f4goh/pwr-swr-meter/README.md

# PWR-SWR-METER

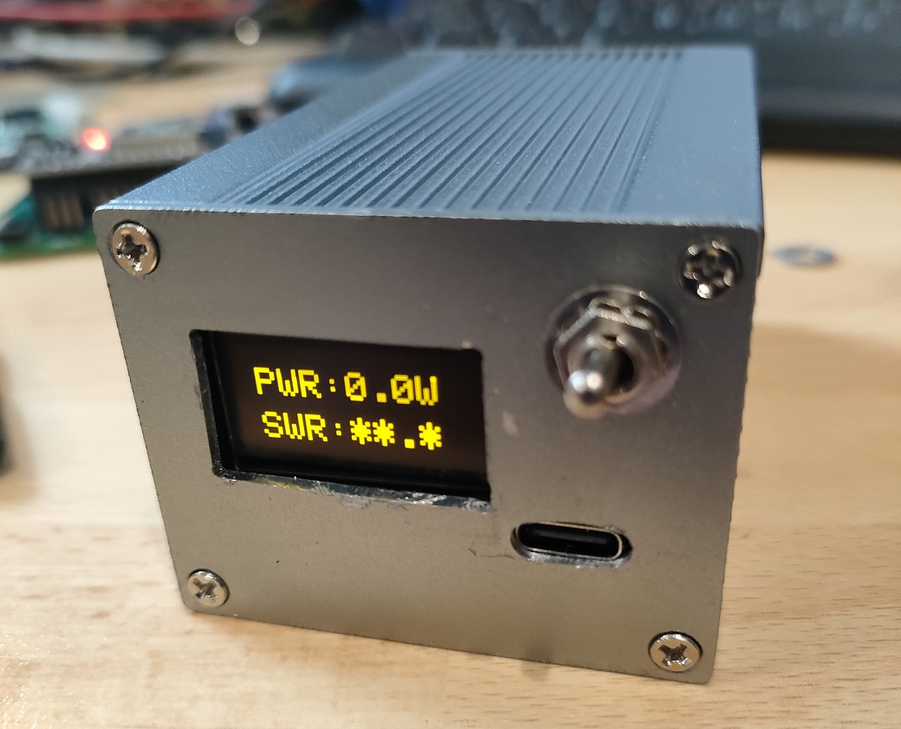
[picture p1: images/swr3.jpg]
swr3 Main board1


## Features :

- 12 Watts max ;
- ATMEGA328p microcontroller with 8 Mhz internal clock ;
- tandem match coupler with BN-43-202 ;
- SSD1306 Oled display ;
- F5BEG's bargraph software ;
- Serial connector for updating with FTDI232 module ;
- BMS (battery management system) ;
- Battery 902535 800mA 3.7V ;
- the programmer used for ATMEGA328p is a [XGECU - pro](https://www.aliexpress.com/premium/XGecu.html) ;
- Initial project from [G8GYW](https://github.com/G8GYW/g8gyw.github.io) for CONSTRUCTING THE TRANSFORMER BN-43-202 .

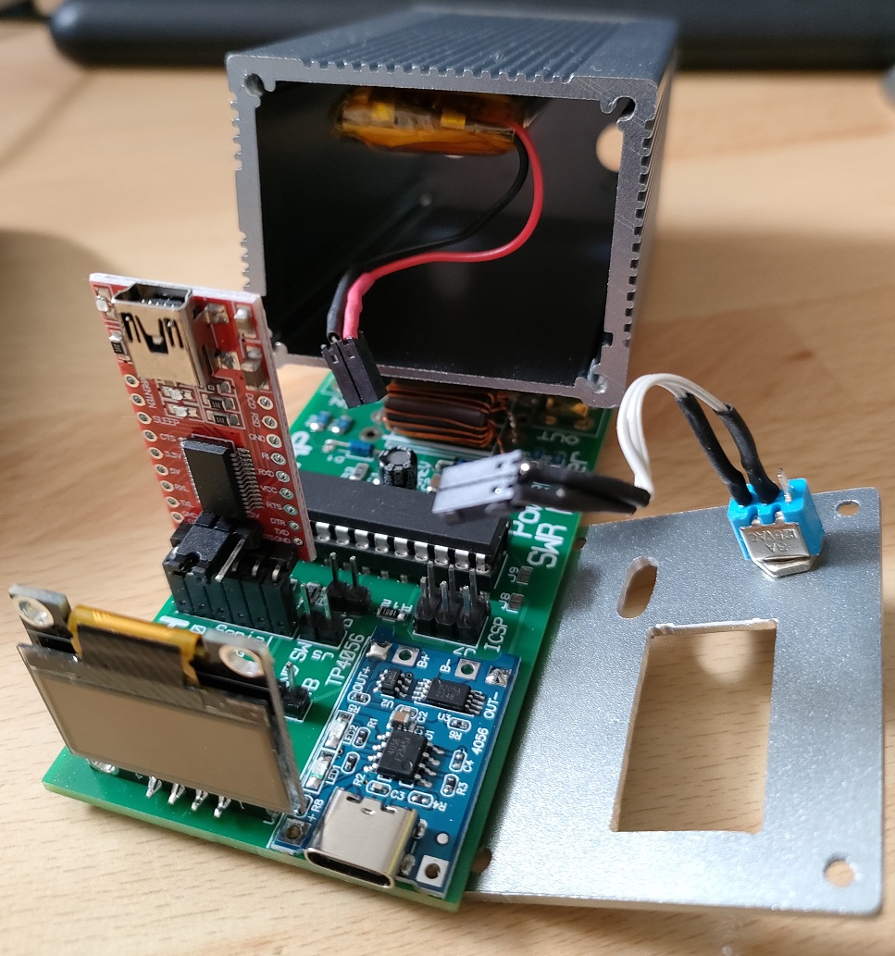
[picture p2: images/total.jpg]
total Main board


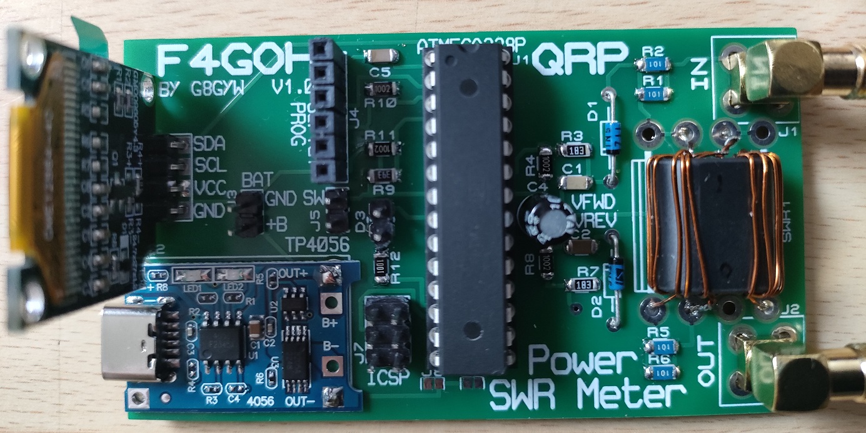
[picture p3: images/swr2.jpg]
swr2 Main board2


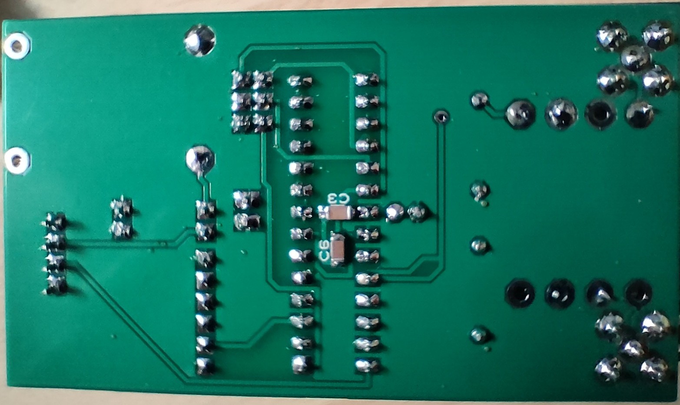
[picture p4: images/swr_back.jpg]
swrback Main board3


## Display :

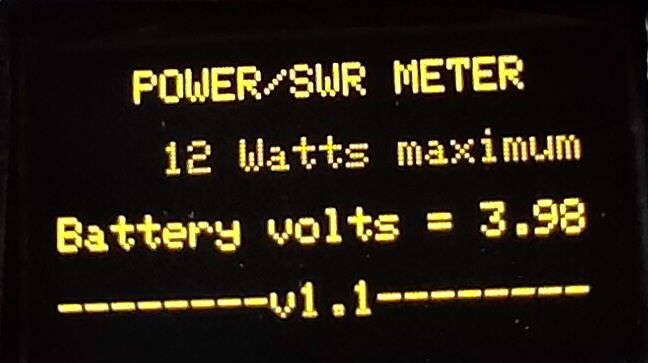
[picture p5: images/intro.jpg]


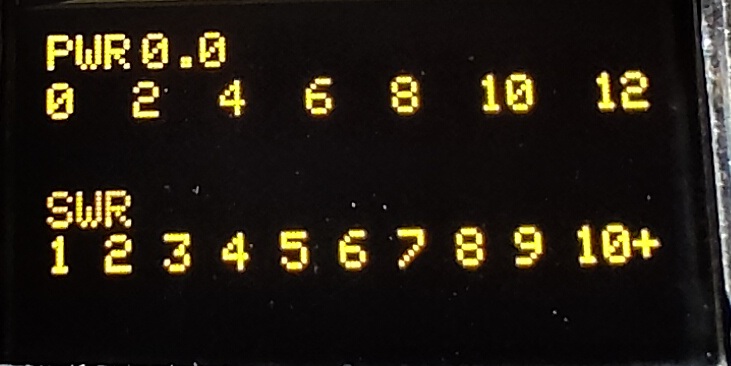
[picture p6: images/init.jpg]


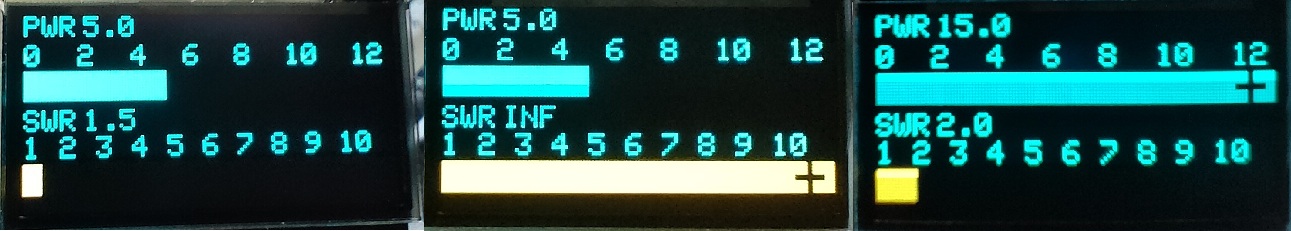
[picture p7: images/pwr_swr.jpg]


## PCB available :

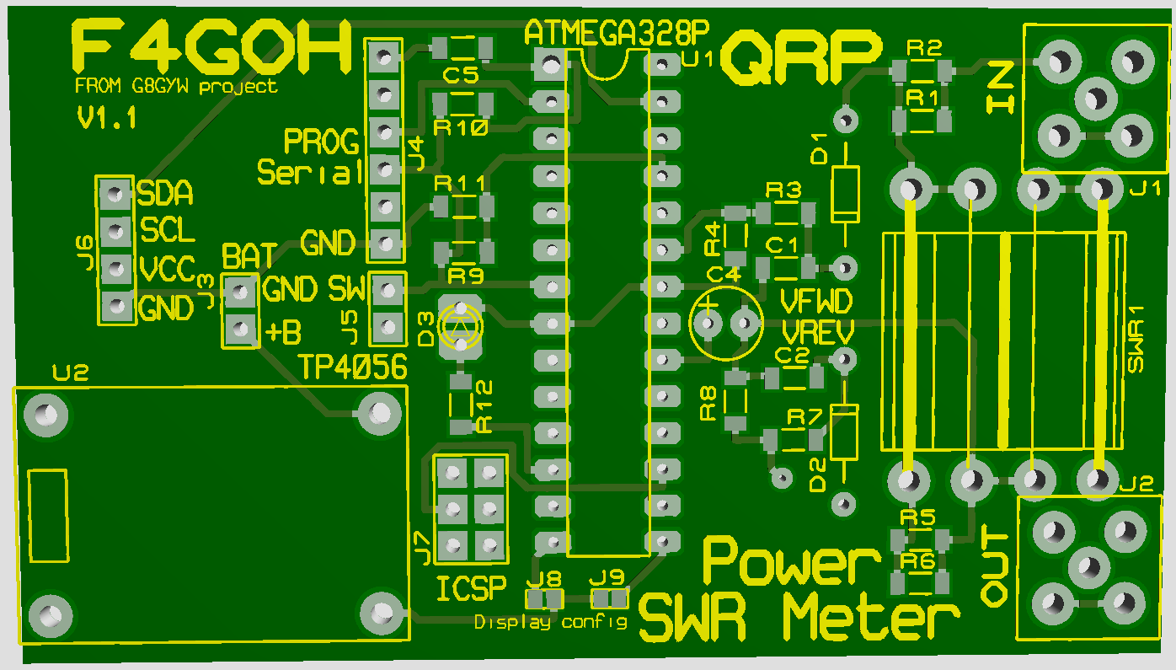
[picture p8: images/swrQRP_PCB.png]
PCB pcb


## F5BCB PWR-SWR-METER :

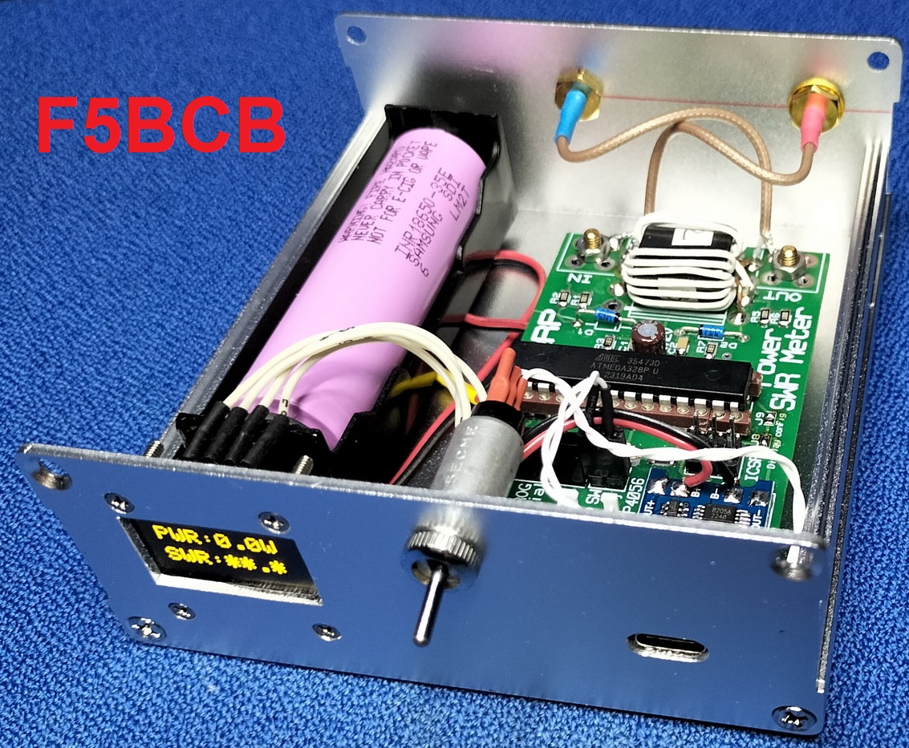
[picture p9: images/F5BCB_1.jpg]
PCB1 pcb1


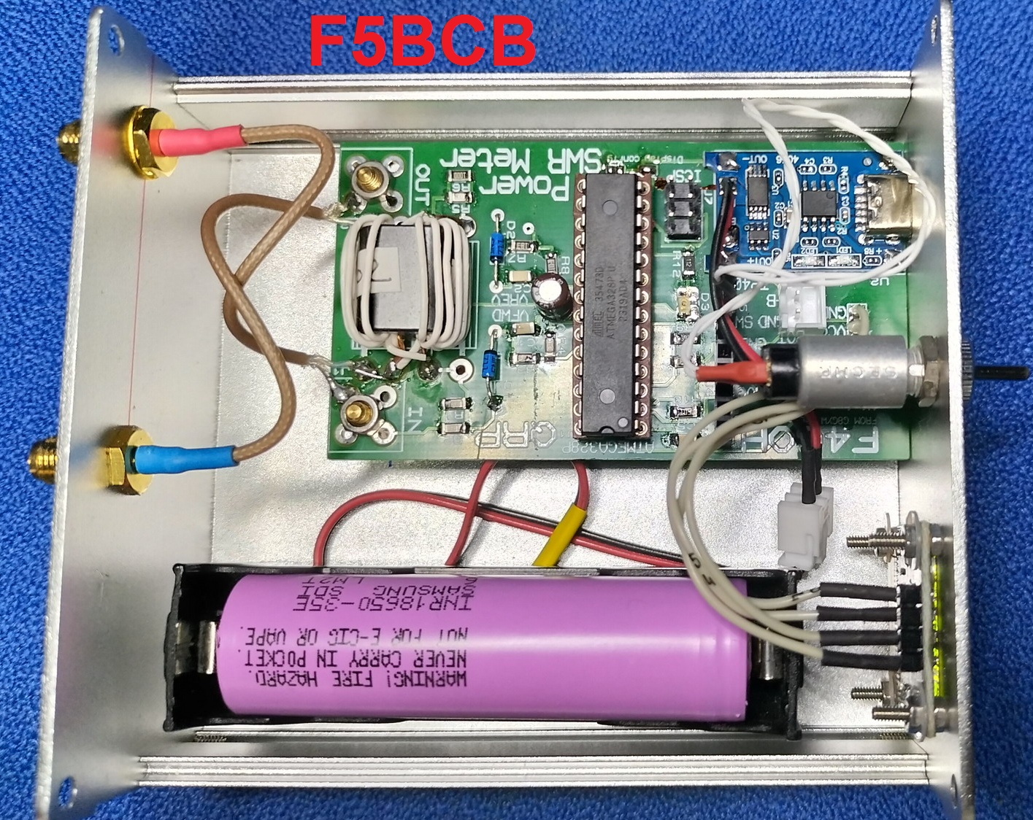
[picture p10: images/F5BCB_2.jpg]
PCB2 pcb2
