f4goh/pwr-swr-meter/programming/README.md

# Software programming with ISP and an Arduino UNO

Use [AVRDUDESS](https://github.com/ZakKemble/AVRDUDESS) with an Arduino UNO to program directly the bootloader and main software (firmware.hex)

## Program an Arduino UNO with AduinoISP software

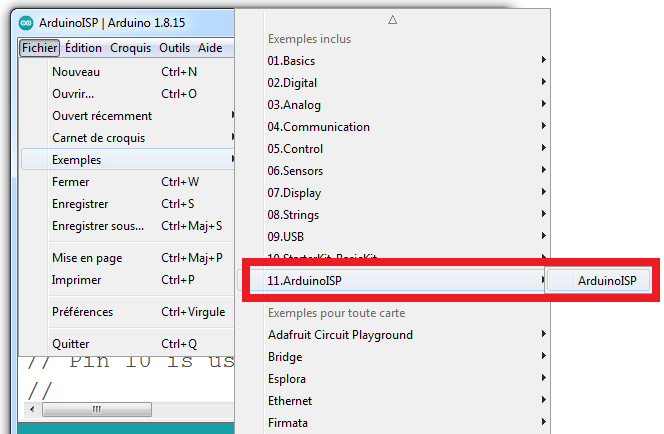
[picture p11: programming/images/Arduino_ISP.png]
isp1


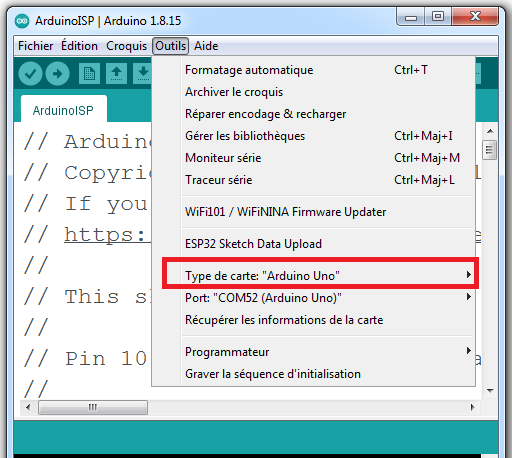
[picture p12: programming/images/Arduino_UNO.png]
isp2


## Connect the Arduino UNO with the SWR power meter
## No battery is connected during this procedure !

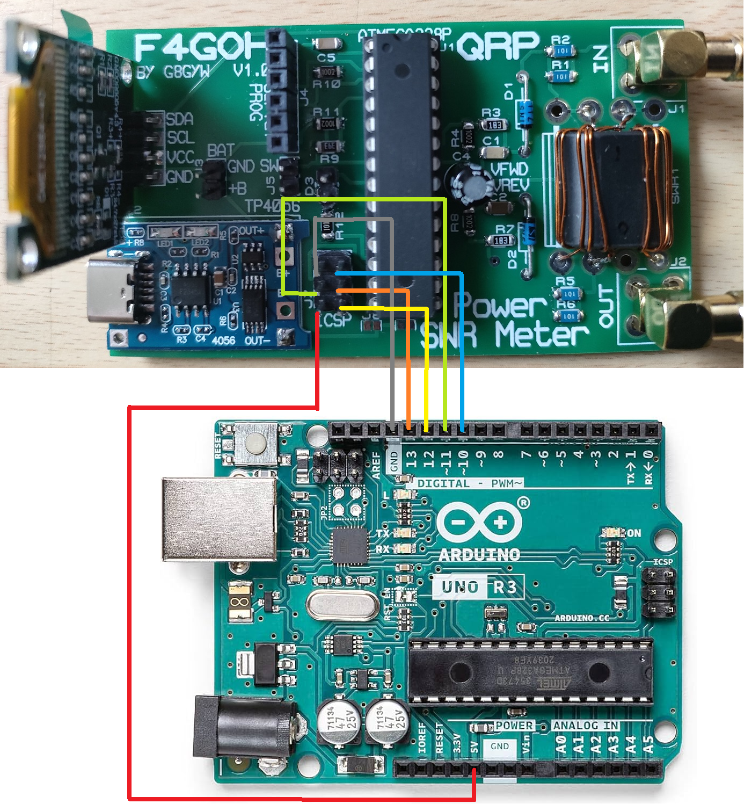
[picture p13: programming/images/Arduino_ISP_wiring.png]
isp3


## Use Avrdudess and program 1,2 and 3

- Arduino board as programmer using arduino ISP firmware
- Select COM port
- Baud rate as 19200
- Select firmware.hex file
- choose write option with format intel HEX
- Select Erase flash and EEPROM
- Program!

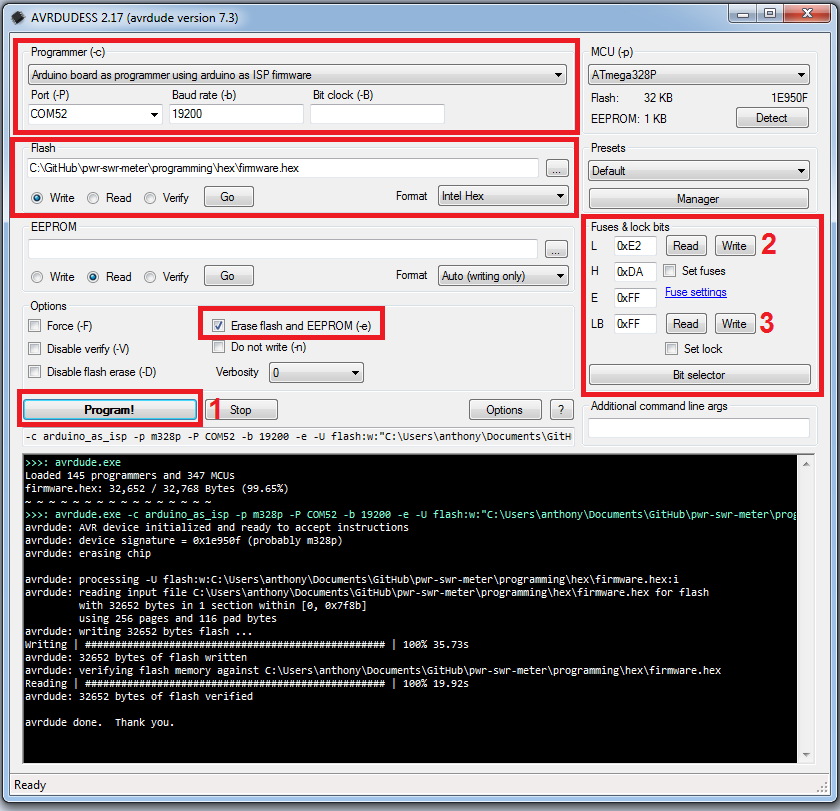
[picture p14: programming/images/avrdudess_en.png]
isp4


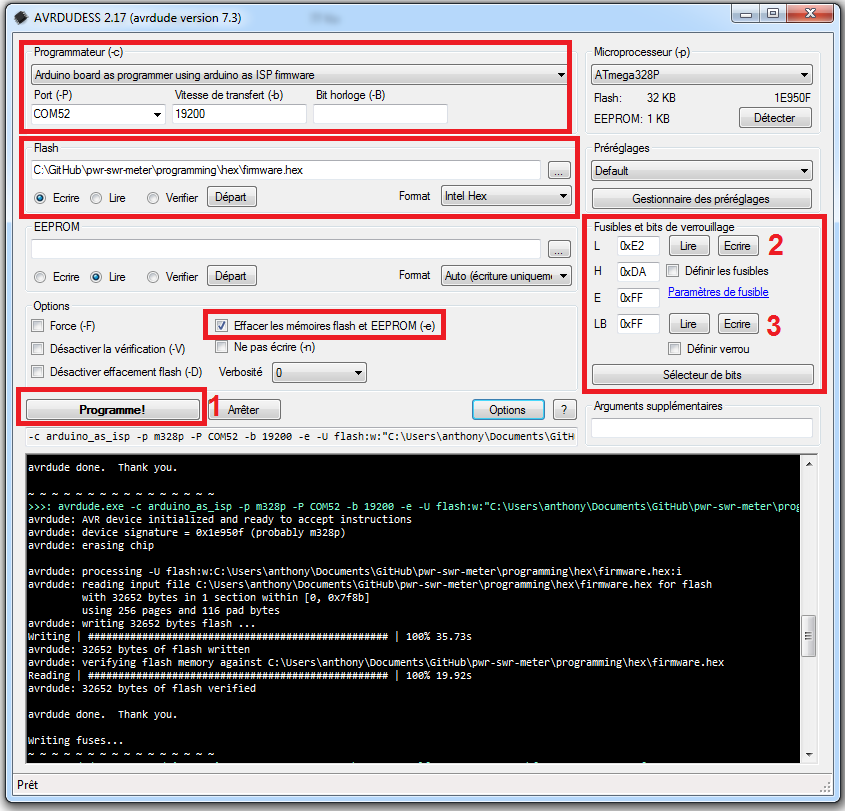
[picture p15: programming/images/avrdudess_fr.png]
isp5


- now check fuse config
- Write fuse config (it select internal 8Mhz clock in atMega328P with bootloader)

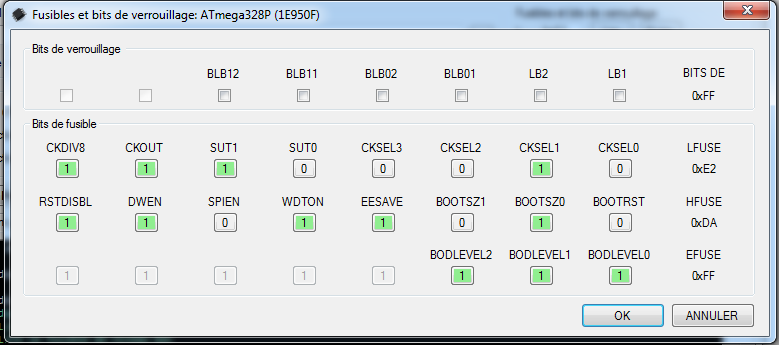
[picture p16: programming/images/fuse.png]
isp6


## Software updating :

if you want to update your own software :

- copy hardware folder into your own Documents/Arduino like C:\Users\anthony\Documents\Arduino
- No need to add MegunoLINK library, Filter.h is included
- Modify QRP_POWER_METER.ino main code
- Select breadBoard-avr in tools menu
- and upload

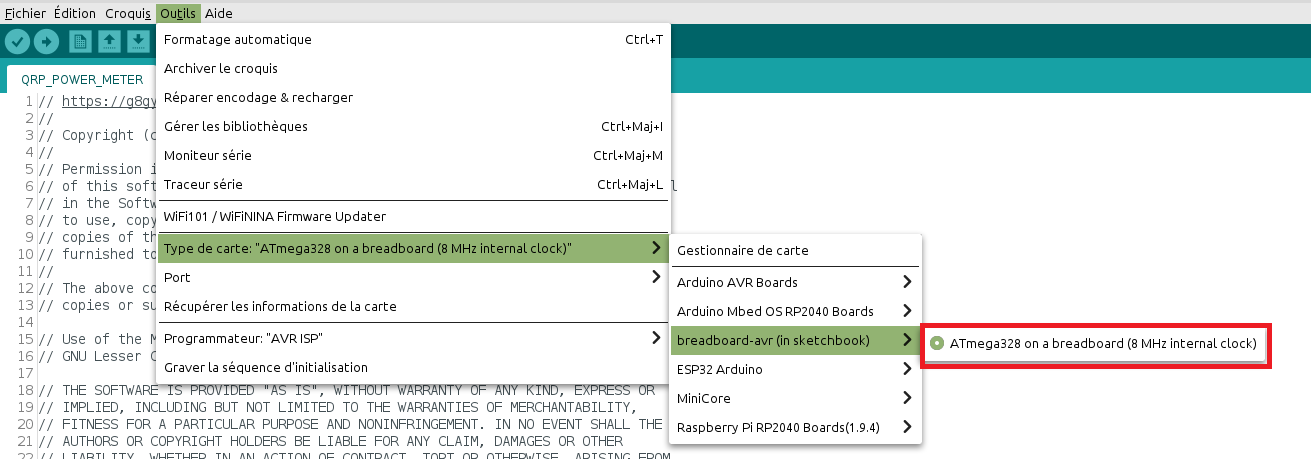
[picture p17: software/source/config.png]
config
