f4goh/pwr-swr-meter/schematics/swrQRP.png

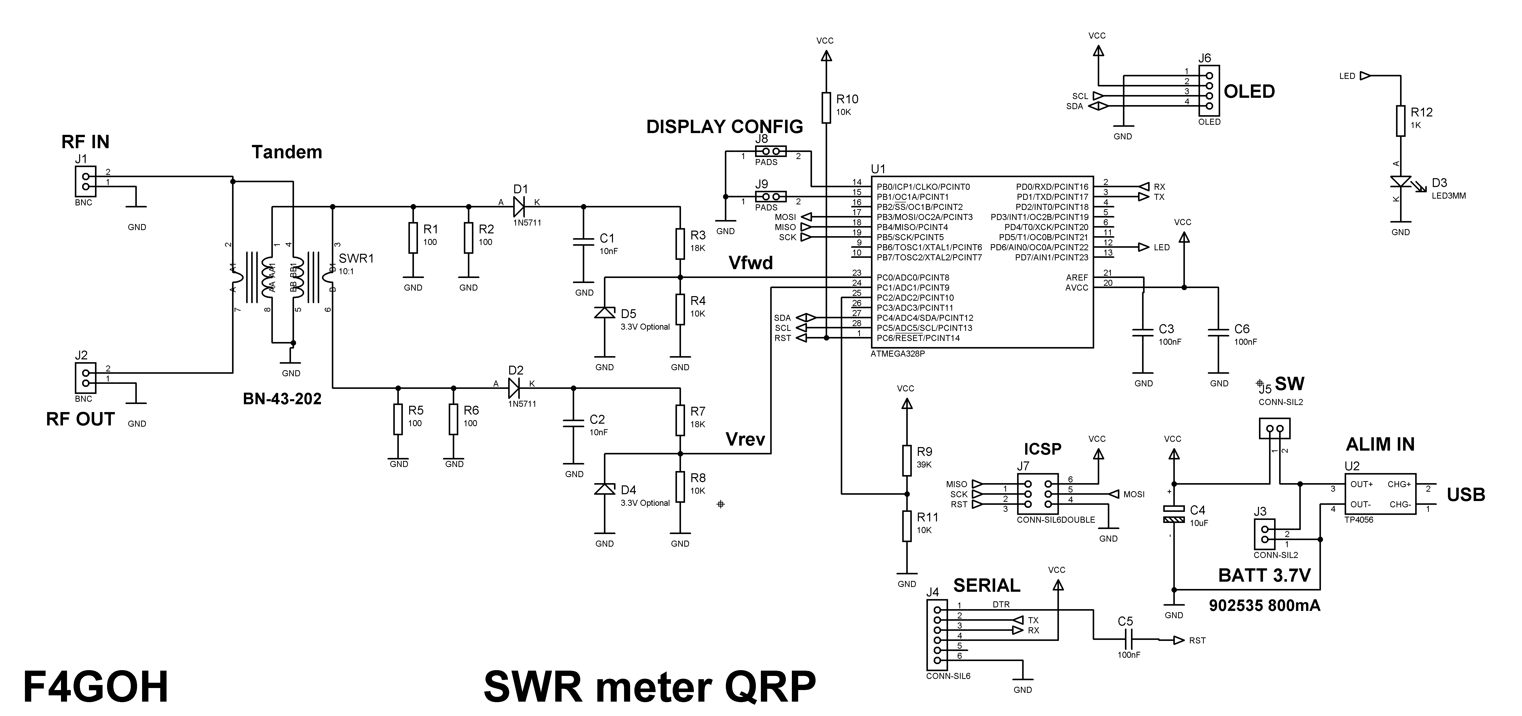
schematics/swrQRP.png
