f4goh/pwr-swr-meter/schematics/tp4056_schematics.png

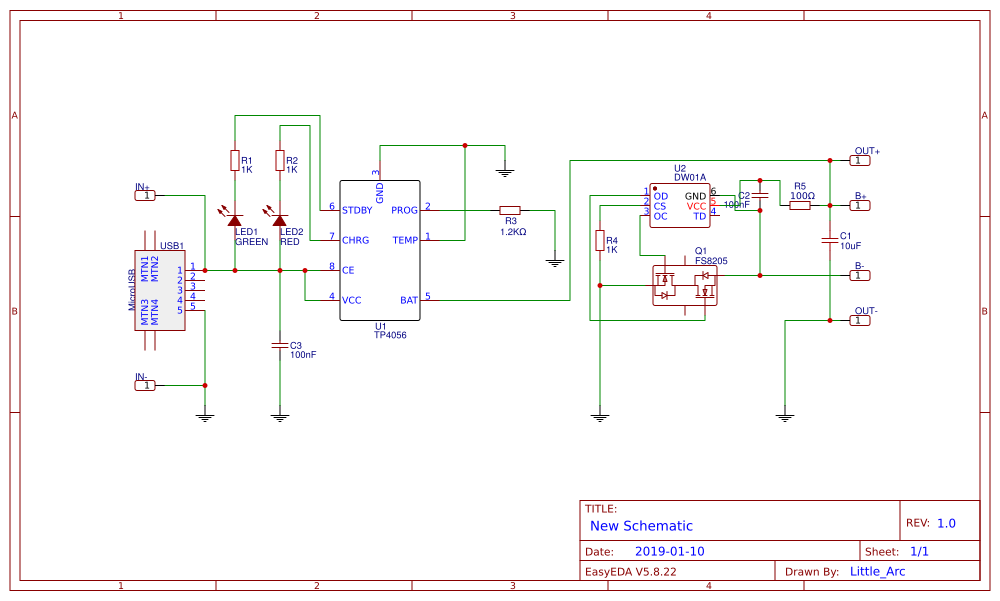
schematics/tp4056_schematics.png
