f4goh/pwr-swr-meter/software/hardware/breadboard/avr/config.png

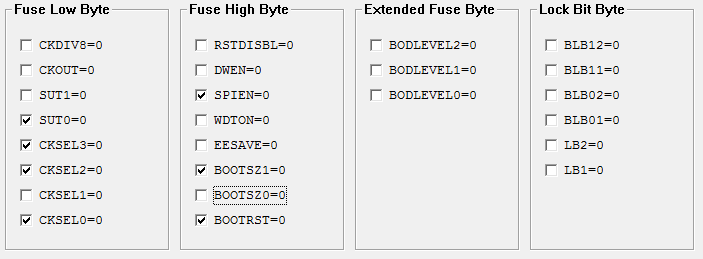
software/hardware/breadboard/avr/config.png
