f4goh/pwr-swr-meter/Materials/Bill Of Materials For swrQRP.xlsx

Category | Reference | Value | price
Resistors 1206 | R1 | 100 | 1 | https://fr.aliexpress.com/item/1005006119604970.html
Resistors 1206 | R2 | 100
Resistors 1206 | R5 | 100
Resistors 1206 | R6 | 100
Resistors 1206 | R3 | 18K
Resistors 1206 | R7 | 18K
Resistors 1206 | R4 | 10K
Resistors 1206 | R8 | 10K
Resistors 1206 | R10 | 10K
Resistors 1206 | R11 | 10K
Resistors 1206 | R9 | 39K
Resistors 1206 | R12 | 1K
Capacitors 1206 | C1 | 10nF | 1 | https://fr.aliexpress.com/item/1005005691620040.html
Capacitors 1206 | C2 | 10nF
Capacitors 1206 | C3 | 100nF
Capacitors 1206 | C5 | 100nF
Capacitors 1206 | C6 | 100nF
Capacitors 1206 | C4 | 10uF | 1 | https://fr.aliexpress.com/item/32895970824.html
Integrated Circuits | U1 | ATMEGA328P+support | 4 | https://fr.aliexpress.com/item/1005004505177113.html
Integrated Circuits | U2 | TP4056 | 0.4
Diodes through hole | D1 | 1N5711 | 1 | https://fr.aliexpress.com/item/1005005678699778.html
Diodes through hole | D2 | 1N5711
Diodes | D3 | LED3MM
Miscellaneous | J1 | SMA | 1 | https://fr.aliexpress.com/item/1005005267415258.html
Miscellaneous | J2 | SMA
Miscellaneous | J3 | CONN-SIL2 | 1 | https://fr.aliexpress.com/item/1005005966318580.html
Miscellaneous | J5 | CONN-SIL2
Miscellaneous | J4 | CONN-SIL6
Miscellaneous | J6 | OLED | 2 | https://fr.aliexpress.com/item/1005006373062872.html
Miscellaneous | J7 | CONN-SIL6DOUBLE male |  | https://fr.aliexpress.com/item/4000873858801.html
Miscellaneous | J8 | PADS
Miscellaneous | J9 | PADS
Miscellaneous | SWR1 | BN43-202 | 3 | https://fr.aliexpress.com/item/1005004219379075.html
Miscellaneous | wire |  |  | https://fr.aliexpress.com/item/1005005549459084.html
Miscellaneous | wire
PCB | PCB |  | 5
CASE |  |  | 5 | https://fr.aliexpress.com/item/33059494990.html
Battery | BAT | 902535 | 6 | https://fr.aliexpress.com/item/1005003306057564.html
 |  | TOTAL | 31.4
