f4goh/pwr-swr-meter/software/source/QRP_POWER_METER/QRP_POWER_METER.ino

// https://g8gyw.github.io/
//
// Copyright (c) 2021 Mike G8GYW 
// update by F4GOH 2024
//
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
// Use of the MegunoLINK filter library is licensed by the copyright owners under the terms of the
// GNU Lesser General Public License: https://github.com/Megunolink/MLP/blob/master/LICENSE.

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
// This program is designed to run on an Atmega328P with internal 8MHz clock and internal bandgap voltage reference.
// It takes the outputs from a Stockton bridge using a 10:1 transformer turns ratio and 1N5711 Scottky diodes,
// applies calibration factors then calculates and displays the average forward power, VSWR and battery voltage.

// ATMEGA FUSE VALUES
// E:FF   H:D7   L:E2

#include <Wire.h>
#include <Adafruit_SSD1306.h>
#include "Filter.h"


#define VERSION   "v1.1"
#define SCREEN_WIDTH 128 // OLED display width, in pixels
#define SCREEN_HEIGHT 64 // OLED display height, in pixels
#define OLED_RESET    -1 // Reset pin # (or -1 if sharing Arduino reset pin)
#define CONFIG_DISPLAY 8

Adafruit_SSD1306 display(SCREEN_WIDTH, SCREEN_HEIGHT, &Wire, OLED_RESET);

// DEFINE VARIABLES

float Vfwd;   // Forward voltage
float Vrev;   // Reverse voltage
float Pfwd;   // Forward power
float Prev;   // Reverse power
float SWR;    // VSWR
float Gamma;  // Reflection coefficient
float Vbat;   // Battery voltage

// CALIBRATION FACTORS
// The tolerance on the Atmega328P's internal voltage reference is 1.0 to 1.2 Volts.
// The actual voltage should be measured on pin 21 and entered below.

// The response of the 1N5711 diodes follows a curve represented by the equation:
// Pfwd = aVfwd^2 + bVfwd (and the same for Prev and Vrev)
// where a and b are constants determined by plotting Power In vs Vfwd and performing a curve fit.
// An excellent tool for this can be found at https://veusz.github.io/
// The values of a and b below can be adjusted if necessary to improve accuracy (try adjusting b first).

const float IntRef = 1.1;
const float a = 1.0;
const float b = 0.75;

// FUNCTIONS TO CALCULATE FORWARD AND REVERSE POWER

float CalculatePfwd ()
{
  float Vadc0 = analogRead(A0); // Read ADC0 (pin 23)
  Vadc0 = constrain(Vadc0, 1, 1023); // Prevent divide-by-zero when calculating Gamma
  Vfwd = 2.8 * ((Vadc0 + 0.5) * IntRef / 1024); // Scaled up by R3 & R4
  Pfwd = a * sq(Vfwd) + b * Vfwd;
  return Pfwd;
}

float CalculateSWR ()
{
  float Vadc1 = analogRead(A1); // Read ADC1 (pin 24)
  Vrev = 2.8 * ((Vadc1 + 0.5) * IntRef / 1024); // Scaled up by R7 & R8
  Prev = a * sq(Vrev) + b * Vrev;
  if (Prev < 0.01)
  { //exclude residual values
    Prev = 0;
  }
  Gamma = sqrt(Prev / Pfwd); // Calculate reflection coefficient

  SWR = (1 + Gamma) / (1 - Gamma);
  SWR = constrain(SWR, 1, 99.9);
  return SWR;
}

// ADC FILTER
// A recursive filter removes jitter from the readings using the MegunoLINK filter library:
// https://www.megunolink.com/documentation/arduino-libraries/exponential-filter/

// Create new exponential filters with a weight of 90 and initial value of 0
// Adjust these values as required for a stable display

ExponentialFilter<float> FilteredPfwd(50, 0);
ExponentialFilter<float> FilteredVSWR(50, 0);

void setup()
{
  ADCSRA &= ~(bit (ADPS0) | bit (ADPS1) | bit (ADPS2)); // Clear prescaler bits
  ADCSRA |= bit (ADPS1) | bit (ADPS2);                  // Set prescaler to 64

  // Enable the internal voltage reference and disable unused digital buffers
  analogReference (INTERNAL);
  bitSet (DIDR0, ADC3D);
  bitSet (DIDR0, ADC4D);
  bitSet (DIDR0, ADC5D);
  pinMode(CONFIG_DISPLAY, INPUT_PULLUP);
  analogRead (A2);  // Read ADC2
  delay (500); // Allow ADC to settle
  float Vpot = analogRead (A2); // Read ADC again
  Vbat = 4.9 * ((Vpot + 0.5) * IntRef / 1024); // Calculate battery voltage scaled by R9 & R10

  // Display startup screen
  Serial.begin(9600);
  display.begin(SSD1306_SWITCHCAPVCC, 0x3C);  //Initialize with the I2C address 0x3C.
  display.setRotation(2);  //0:normal 1:90deg  2:180deg
  display.clearDisplay();
  display.setTextSize(1);
  display.setTextColor(WHITE);
  display.setCursor(0, 0);
  display.print("   POWER/SWR METER   ");
  display.setCursor(0, 16);
  display.print("    12 Watts maximum    ");
  display.setCursor(0, 32);
  display.print("Battery volts = ");
  display.print(Vbat);
  display.setCursor(0, 48);
  display.print("--------");
  display.print(VERSION);
  display.print("--------");
  //display.drawLine(0,0,10,10,WHITE);
  display.display();
  delay(5000);        // delay 5 seconds

}

void standardDisplay(float spwr, float sswr) {
  // Display Power and VSWR
  //spwr = 5;   //test
  //sswr = 15;
  display.clearDisplay();
  display.setTextSize(2);
  display.setCursor (12, 10);
  display.print("PWR: ");
  display.setCursor (60, 10);
  display.print(spwr, 1); // Display forward power to one decimal place
  display.print("W");
  display.setCursor (12, 34);
  display.print("SWR: ");
  display.setCursor (60, 34);
  if (Pfwd < 0.01)
  { display.print("**.*"); // Blank invalid readings
  }
  else {
    if (sswr > 12) {
      display.print("INF");
    }
    else {
      display.print(sswr, 1); // Display VSWR to one decimal place
    }
    if (sswr > 3) {
      display.setCursor (12, 50);
      display.print("WARNING !");
    }
  }
  display.display();
}

void drawScale() {
  display.setTextSize(1);
  display.setCursor (0, 0);
  display.print("PWR");
  display.setCursor (0, 10);
  //display.print("|  |  |  |  |  |  |  |");
  display.print("0  2  4  6  8  10  12");
  display.setCursor (0, 32);
  display.print("SWR");
  display.setCursor (0, 41);
  display.print("1 2 3 4 5 6 7 8 9 10+");

}

void drawBargraph(int x, int y, int value) {
  display.fillRect(x, y, x + value, 10, SSD1306_WHITE);
}


void bargraphDisplay(float spwr, float sswr) {
  // Display Power and VSWR
  //spwr = 15;   //test
  //sswr = 2;
  display.clearDisplay();
  drawScale();
  int pwr, swr;
  pwr = map((int)(spwr * 10), 0, 120, 0, 117);
  drawBargraph(0, 19, pwr);
  display.setCursor (20, 0);
  display.print(spwr, 1);
  if (spwr > 12) {
    display.setTextSize(2);
    display.setTextColor(0);
    display.setCursor (115, 17);
    display.print("+");
    display.setTextColor(1);
    display.setTextSize(1);
  }
  if (Pfwd >= 0.01)
  {
    swr = map((int)(sswr * 10), 10, 100, 0, 117);
    drawBargraph(0, 48, swr);
    if (sswr > 12) {
      display.setTextSize(2);
      display.setTextColor(0);
      display.setCursor (115, 46);
      display.print("+");
      display.setTextColor(1);
      display.setTextSize(1);
      display.setCursor (20, 32);
      display.print("INF");
    }
    else {
      display.setCursor (20, 32);
      display.print(sswr, 1);
    }
  }
  display.display();
}

void loop()
{
  float Power = CalculatePfwd(); // Get new value of forward power
  FilteredPfwd.Filter(Power); // Apply filter to new value
  float SmoothPower = FilteredPfwd.Current(); // Return current value of filter output

  float VSWR = CalculateSWR(); // Get new value of VSWR
  FilteredVSWR.Filter(VSWR); // Apply filter to new value
  float SmoothVSWR = FilteredVSWR.Current(); // Return current value of filter output
  if (digitalRead(CONFIG_DISPLAY)) {
    standardDisplay(SmoothPower, SmoothVSWR);
  }
  else {
    bargraphDisplay(SmoothPower, SmoothVSWR);
  }

}
